astrovariable/Ku-Band-Radio-Detector/Aircraft Detection.png

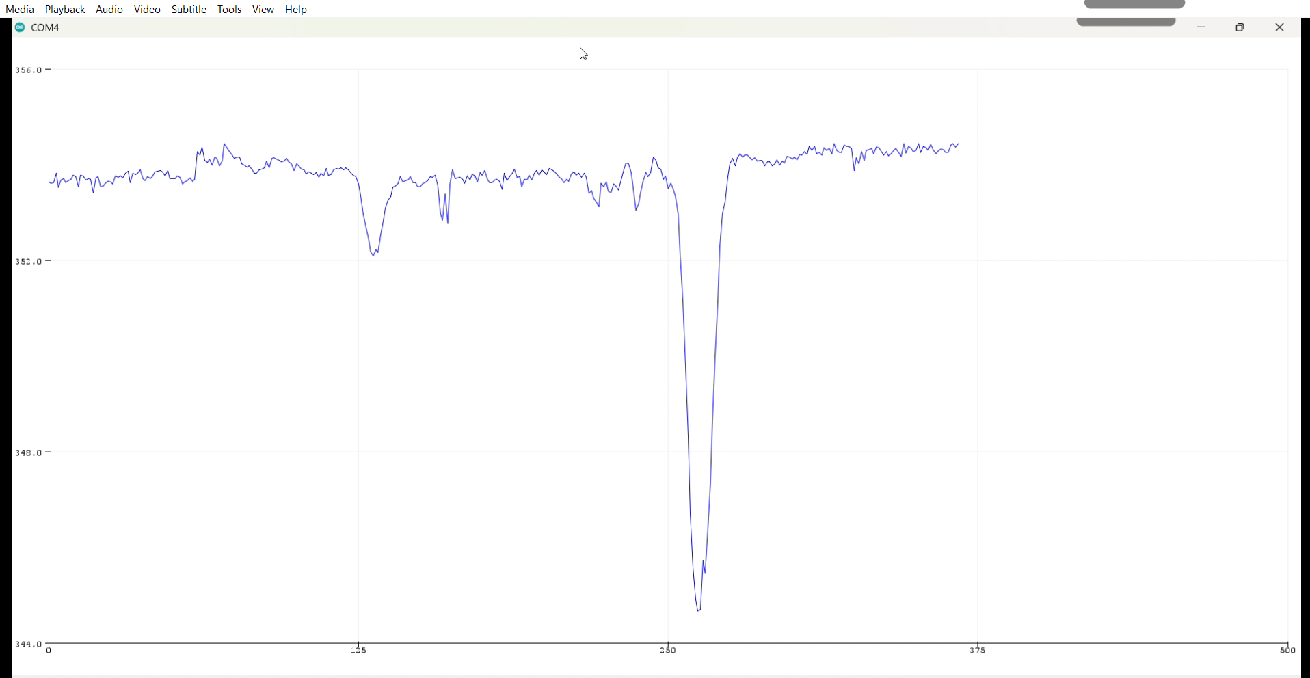
Aircraft Detection.png
