astrovariable/Ku-Band-Radio-Detector/parabolic dish.jpg

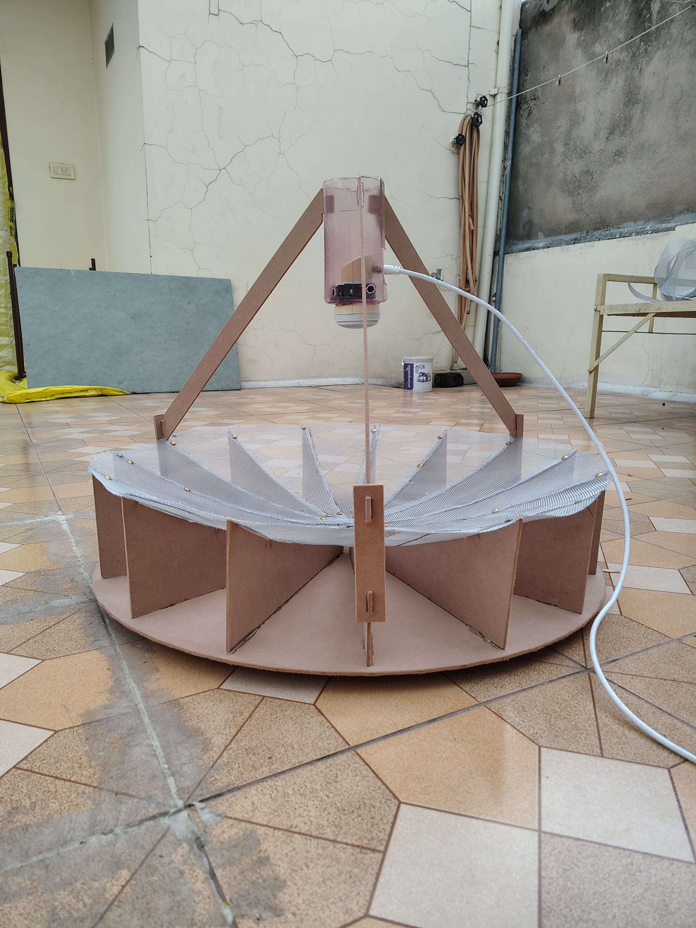
parabolic dish.jpg
