astrovariable/Ku-Band-Radio-Detector/Detection Chain.jpg

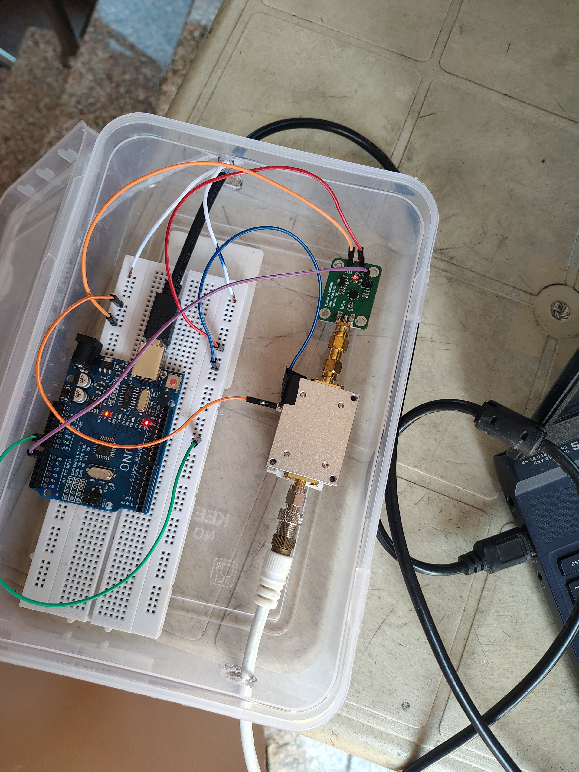
Detection Chain.jpg
